Max-Y-Ma/ECE-385/README.md

# ECE-385
Repository for ECE 385 Labs

Google Drive Folder for Lab Reports: https://drive.google.com/drive/folders/1IDm4uJgUrv-CRCThsT9souQDmplNP_dR?usp=sharing
