Max-Y-Ma/ECE-385/Lab5/Report/Lab Report #5 Extra Credit.pdf

# ECE 385

### Spring 2023 Experiment #5 EC

# MIPS Calculations

### Max Ma & Dhruv Kulgod NL / Friday 9:15 AM - 9:30 AM Nick Lu

Overview
SignalTap, a Logic Analyzer IP Core that is integrated into the FPGA fabric of a given design, was used to probe signals during each test program: XOR, Multiplier, and Sort. The signals that were probed were the Program Counter (PC), and HEX0, HEX1, HEX2, and HEX3. The PC register was chosen as the trigger signal. SignalTap was configured to trigger on specific PC values for each of the three required tests. Once the waveforms were captured, they were analyzed to determine the SLC-3 MIPS (millions of instructions per second). The number of instructions were counted for each test. Moreover, the number of cycles was determined by the number of samples taken during each test. This metric was utilized because each sample is taken on the positive edge of the system clock, which corresponds to one clock cycle.

XOR Test Results
The trigger for this test was PC = 0x1A, which corresponds to the moment after the second input value is entered. The captured logic analyzer waveform is shown below in Figure 1. The number of cycles was able to be measured from the sample bar above Figure 1. The number of instructions was counted from the full SignalTap waveform.

Calculations: 9 Instructions, 67 Cycles

9 Instructions

67 Cycles × 50, 000, 000 Cycles

Second ≈ 6, 716, 418 Instructions
Second ≈ 6. 716 MIPS

Figure 1: XOR Test SignalTap Waveform

Multiplier Test Results
The trigger for this test was PC = 0x3A, which starts capturing right after the second input value is entered. The captured logic analyzer waveform is shown below in Figure 2 and Figure 3. The number of cycles was able to be measured from the sample bar above Figure 3. The number of instructions was counted from the full SignalTap waveform.

Calculations: 79 Instructions, 580 Cycles

79 Instructions

580 Cycles × 50, 000, 000 Cycles

Second ≈ 6, 810, 344 Instructions
Second ≈ 6. 810 MIPS

Figure 3: Multiplier Test SignalTap Waveform - Head

Figure 3: Multiplier Test SignalTap Waveform - Tail Sort Test Results
The trigger for this test was PC = 0x77, which is the first instruction when executing the bubble sort algorithm. The captured logic analyzer waveform is shown below in Figure 4 and Figure 5. The number of cycles was able to be measured from the sample bar above Figure 5. The number of instructions was computed using a Python program illustrated in Figure 6 and Figure 7.

Calculations: 1, 638 Instructions, 12, 150 Cycles

1,638 Instructions

12,150 Cycles × 50, 000, 000 Cycles

Second ≈ 6, 740, 741 Instructions
Second ≈ 6. 741 MIPS

Figure 4: Sort Test SignalTap Waveform - Head

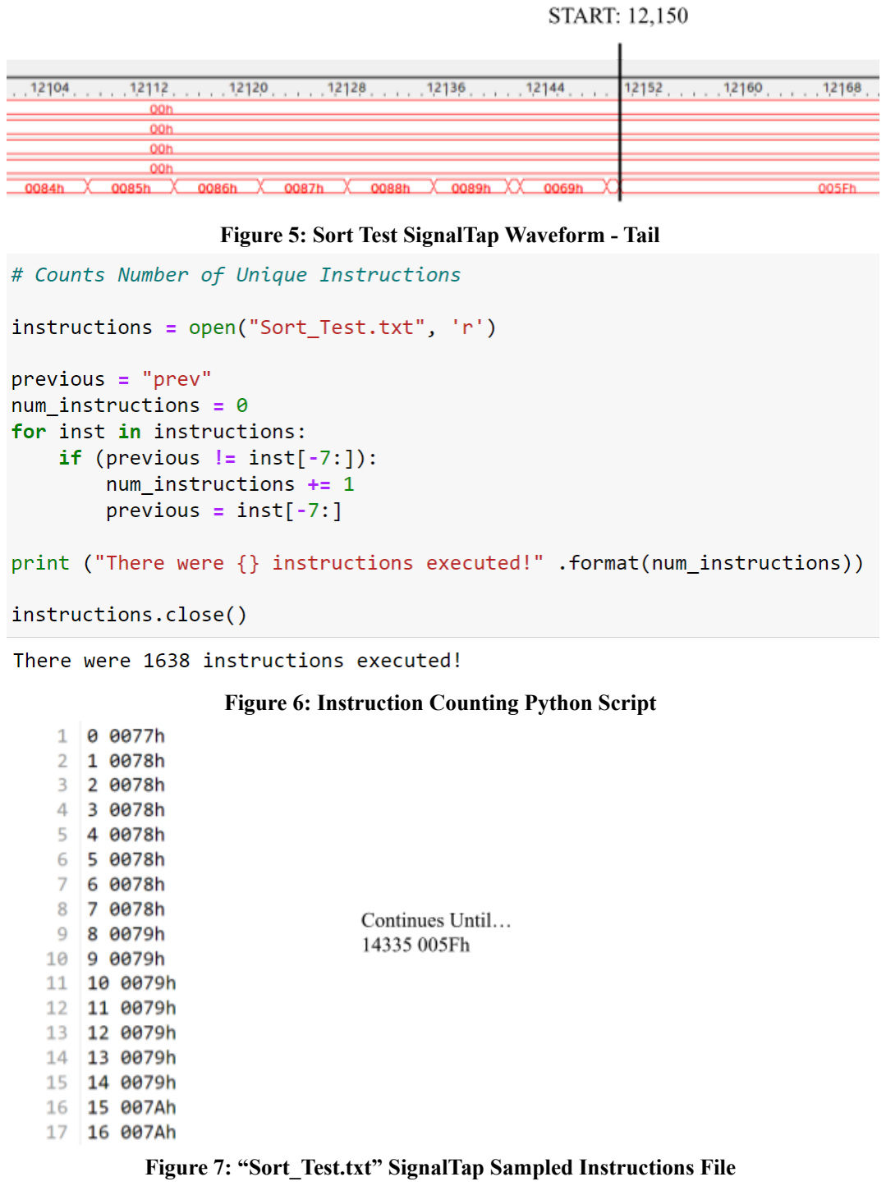
[picture p1: page 4]

Figure 5: Sort Test SignalTap Waveform - Tail

Figure 6: Instruction Counting Python Script

Figure 7: “Sort_Test.txt” SignalTap Sampled Instructions File

Conclusion
After computing the results from each test, the average SLC-3 MIPS is:

Calculations: 6.716 MIPS + 6.810 MIPS + 6.741 MIPS
3 | =

20.267 MIPS
3 ≈ 6. 756 MIPS

This is comparable to the Intel 8048 from 1980!
