Max-Y-Ma/ECE-385/Lab2/Week2/Report/State Diagram Moore FPGA.png

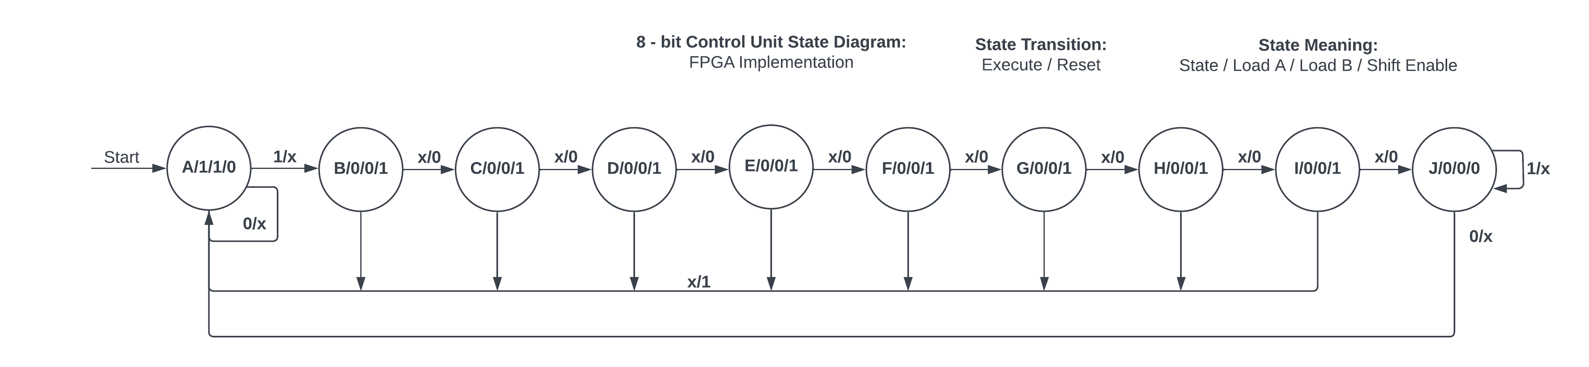
Lab2/Week2/Report/State Diagram Moore FPGA.png
