Max-Y-Ma/ECE-385/(list of files, cad)

Other CAD files:
Lab2/Week2/Logic_Processor_8bit/db/demo_signal_tap_auto_stripped.stp
Lab2/Week2/Logic_Processor_8bit/demo_signal_tap.stp
Lab5/slc_microprocessor/stp3.stp
Lab5/slc_microprocessor/Multiply_Test.stp
