Max-Y-Ma/ECE-385/Lab5/Experiment 5 Test Cases.pdf

# ECE 385 SLC-3 Test Programs

For each test program, the point value and starting address (in hex) is given, followed by a list of instructions used in the test program, and a description of what the program does. To begin each test, input the starting address on the switches and press “Run”.

Note that the top button is typically mapped to "Run" and the bottom button mapped to "Continue", and both buttons pressed simultaneously is the "Reset" functionality.

In the descriptions of the test programs, the term “Checkpoint” is used to refer to a pause instruction with a specified value. “Checkpoint 1” would be a pause instruction that displays
x01 on the LEDs (excluding any I/O flags).

Basic I/O Test 1
Program Start: | x0003
Instructions Tested: | ANDi, LDR, STR, BR

This program uses ANDi to clear R0 (i.e., ANDi R0, R0, 0), which is used as a base register for memory operations (using negative values for the offset). All test programs do this to set up for I/O operations. The program then reads in the data on the switches, writes this value to the hex display, and loops back (using BRnzp as an unconditional jump) to repeat the process indefinitely. When working correctly, the hex displays should appear to always display the value of the switches.

Basic I/O Test 2
Program Start:
Instructions Tested:

x0006
ANDi, LDR, STR, BR, PSE

The code for this program is identical to the previous test, except that it uses pause instructions to ask for input and report output. The first pause instruction (checkpoint 1) will ask for input on the switches. The second and subsequent pauses will display x02 and both ask for input and report that an output is present on the hex display. When operating correctly, each press of the Continue button will transfer the value from the switches to the hex display, but the hex display will not change until Continue is pressed.

Self-Modifying Code Test
Program Start: | x000B
Instructions Tested: | ANDi, ADDi, LDR, STR, BR, JSR, PSE

This program is based upon the same loop as the previous test, but inserts some additional operations. Before the loop begins, JSR 0 is executed. This serves to put the PC address in R7 without actually changing the value of PC. (This usage is common in the remaining tests as well). This PC value is used to load the data for the second pause instruction into a register. The loop then operates normally, except that in each iteration, the data for the pause instruction is incremented and stored back to the proper memory location. The result is that with each iteration of the loop, the pause instruction will display a value on the LEDs one greater than the value in the last iteration.

Auto Counting Test
Program Start: | x009C
Instructions Tested: | ANDi, ADDi, JSR, LDR, STR, BR

This program will display an automatically incrementing counter to the hex displays without the need of inputs after jumping to the program. It loads preset constants into R1 and R2 using LDR which serve as counting variables in a double for loop to create delay between the counter increments. After each loop iteration, the respective counter variable is decremented using the ADDi instruction (ADD R <- R - 1). To traverse between the for loops, the BR instruction is used.

XOR Test
Program Start: | x0014
Instructions Tested: | AND, ANDi, NOT, LDR, BR, PSE

This program performs XOR operation. In sLC-3, there is no dedicated XOR instruction, so the XOR is performed by multiple simple instructions (AND and NOT). The program will ask for input values (checkpoints 1 and 2), XOR them, and display the result on the hex display (checkpoint 3). It will then loop back to the top and repeat the process from checkpoint 1.

Multiplication Test (or, “Lab 4 in Software”)
Program Start: | x0031
Instructions Tested: | AND, ANDi, ADD, ADDi. NOT, LDR, STR, BR, JSR, PSE

This program performs multiplication, using a variation on the shift-and-add algorithm (using ADD Rx, Rx, Rx as a left-shift operation). The program will ask for input values (checkpoints 1 and 2), multiply them, and display the result on the hex display (checkpoint 3). It will then loop back to the top and repeat the process from checkpoint 1. Note multiplication is performed on unsigned values, so negative multiplications are not supported.

Sort Test
Program Start:
Instructions Tested:

x005A
<all>

This program is organized into four parts. The first part is a menu, containing function calls to the other three parts that are executed based on input. The menu contains a single pause instruction, checkpoint –1 (displays xFF on the LEDs). Entering x0001 will call the “data entry” function, entering x0002 will call the “sort” function, and entering x0003 will call the “display” function. Any other value will simply cause the menu to loop back to the start without doing anything.

The data entry function allows the user to enter new data into the list to be sorted. The list is fixed at length 16, no more, no less. The function will display the current index (starting at 0) to be written to the list, and ask for data from the switches (checkpoint 1). It will do this 16 times, displaying the current index each time, before returning control to the menu loop.

The sort function will sort the values in the list using the Bubble Sort algorithm. No feedback is given to the user about the completion of the algorithm; it will return (seemingly) immediately to the menu.

The display function will display, in turn, each member of the list (checkpoint 2). Note that since the hex display will be used to display the data, the index of the value is displayed on the LEDs (LED<7:4>), using the self-modifying code technique used earlier to change the pause instruction in each iteration. A properly sorted list will be displayed in ascending order.
To test this program, the data entry function needs not be used, since sample values are pre-loaded into the list along with the program itself. These values, both in their original order and sorted order, are in Table 1. It is recommended that to demo, the display function should be run first to verify that the sample values are present and unsorted, the sort function should be run second, and the display function should be run again to verify that the sort was successful.

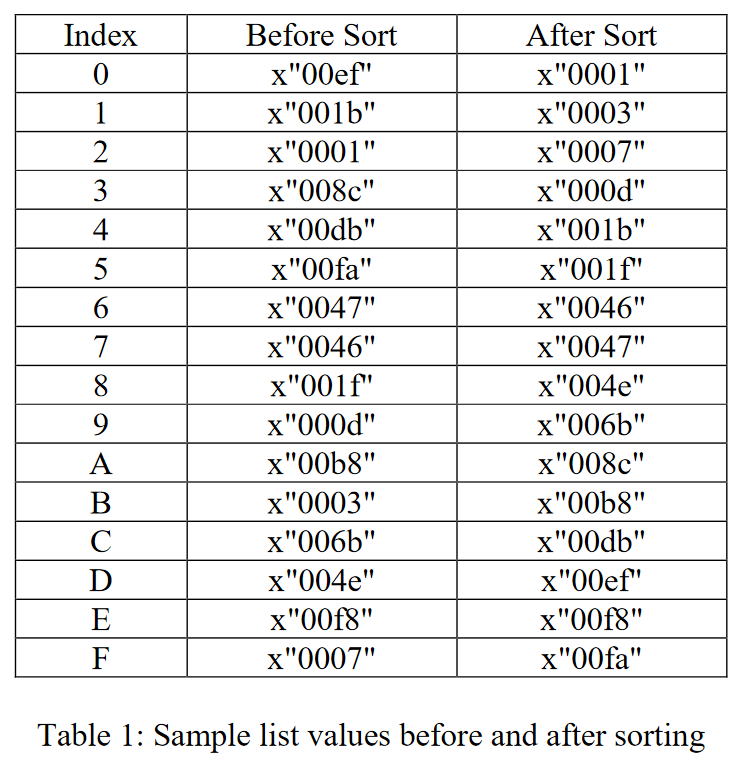
[picture p88: figure]

“Act Once” Test
Program Start: | x002A
Instructions Tested: | ANDi, ADDi, STR, JSR, JMP, PSE

This program is a simple loop that counts up from zero, once per iteration, and displays the count on the hex display (checkpoint 1). When operating correctly, the counter will increase by one (no more, no less) with each press of Continue (i.e., the CPU will act once per press.) This test need only be run if the “act once” functionality of the run or continue buttons is called into question in the course of running other tests. At the TA’s discretion, if this functionality appears to be present during observation of other tests, especially after the display function of the sort test, the points for this test may be awarded without running the test itself.
