Max-Y-Ma/ECE-385/Lab5/Instruction_Counter/Sort_Test.txt

0 0077h 
1 0078h 
2 0078h 
3 0078h 
4 0078h 
5 0078h 
6 0078h 
7 0078h 
8 0079h 
9 0079h 
10 0079h 
11 0079h 
12 0079h 
13 0079h 
14 0079h 
15 007Ah 
16 007Ah 
17 007Ah 
18 007Ah 
19 007Ah 
20 007Ah 
21 007Ah 
22 007Bh 
23 007Bh 
24 007Bh 
25 007Bh 
26 007Bh 
27 007Bh 
28 007Bh 
29 007Bh 
30 007Bh 
31 007Bh 
32 007Bh 
33 007Ch 
34 007Ch 
35 007Ch 
36 007Ch 
37 007Ch 
38 007Ch 
39 007Ch 
40 007Ch 
41 007Ch 
42 007Ch 
43 007Ch 
44 007Dh 
45 007Dh 
46 007Dh 
47 007Dh 
48 007Dh 
49 007Dh 
50 007Dh 
51 007Eh 
52 007Eh 
53 007Eh 
54 007Eh 
55 007Eh 
56 007Eh 
57 007Eh 
58 007Fh 
59 007Fh 
60 007Fh 
61 007Fh 
62 007Fh 
63 007Fh 
64 007Fh 
65 0080h 
66 0080h 
67 0080h 
68 0080h 
69 0080h 
70 0080h 
71 0080h 
72 0081h 
73 0081h 
74 0081h 
75 0081h 
76 0081h 
77 0081h 
78 0081h 
79 0081h 
80 0081h 
81 0081h 
82 0081h 
83 0082h 
84 0082h 
85 0082h 
86 0082h 
87 0082h 
88 0082h 
89 0082h 
90 0082h 
91 0082h 
92 0082h 
93 0082h 
94 0083h 
95 0083h 
96 0083h 
97 0083h 
98 0083h 
99 0083h 
100  0083h 
101  0083h 
102  0083h 
103  0083h 
104  0083h 
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
127  007Ah 
128  007Ah 
129  007Ah 
130  007Ah 
131  007Ah 
132  007Ah 
133  007Ah 
134  007Bh 
135  007Bh 
136  007Bh 
137  007Bh 
138  007Bh 
139  007Bh 
140  007Bh 
141  007Bh 
142  007Bh 
143  007Bh 
144  007Bh 
145  007Ch 
146  007Ch 
147  007Ch 
148  007Ch 
149  007Ch 
150  007Ch 
151  007Ch 
152  007Ch 
153  007Ch 
154  007Ch 
155  007Ch 
156  007Dh 
157  007Dh 
158  007Dh 
159  007Dh 
160  007Dh 
161  007Dh 
162  007Dh 
163  007Eh 
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
14313 005Fh 
14314 005Fh 
14315 005Fh 
14316 005Fh 
14317 005Fh 
14318 005Fh 
14319 005Fh 
14320 005Fh 
14321 005Fh 
14322 005Fh 
14323 005Fh 
14324 005Fh 
14325 005Fh 
14326 005Fh 
14327 005Fh 
14328 005Fh 
14329 005Fh 
14330 005Fh 
14331 005Fh 
14332 005Fh 
14333 005Fh 
14334 005Fh 
14335 005Fh
