Max-Y-Ma/ECE-385/Lab5/Report/Simulations/I_O_Test_1.pdf

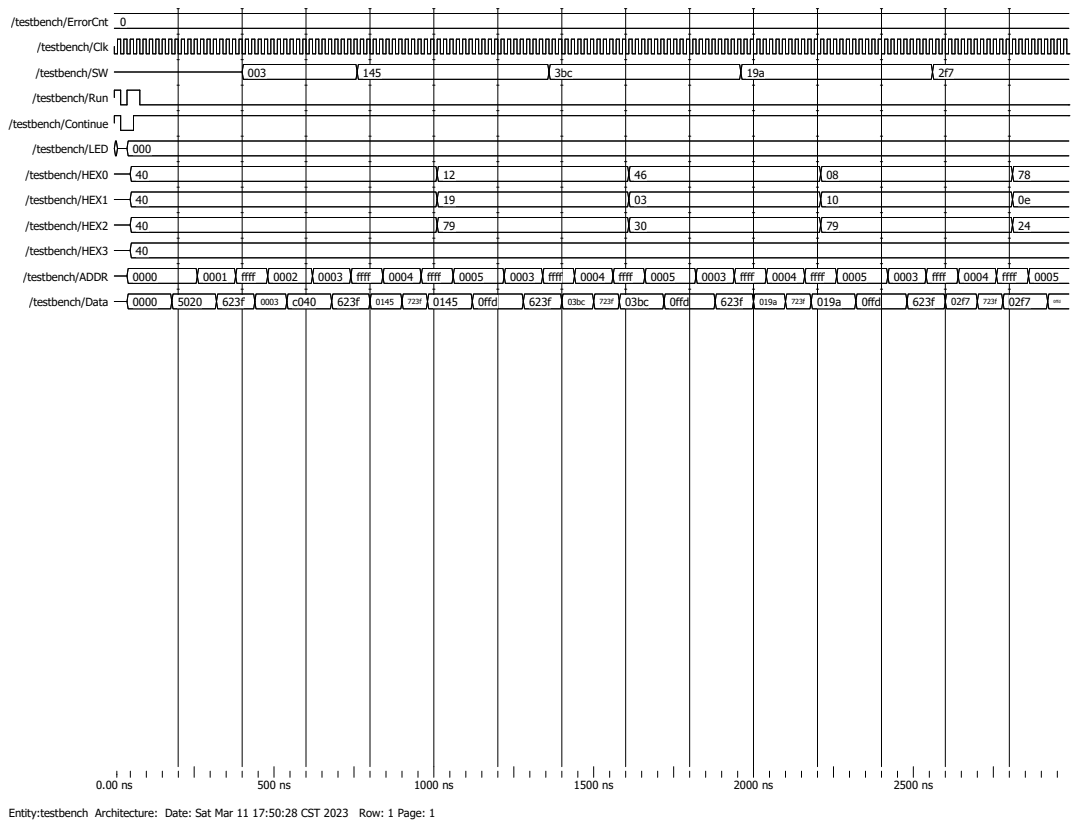
[picture p101: page 1]
ffff; 0003 ffff; 0004 ffff; 0ffd; /testbench/ErrorCnt 0; /testbench/Clk; /testbench/SW; /testbench/Run; /testbench/Continue; /testbench/LED; /testbench/HEX0; /testbench/HEX1; /testbench/HEX2; /testbench/HEX3; /testbench/ADDR; /testbench/Data

Entity:testbench Architecture: Date: Sat Mar 11 17:50:28 CST 2023 Row: 1 Page: 1
