Max-Y-Ma/ECE-385/Lab5/Report/Simulations/I_O_Test_2.pdf

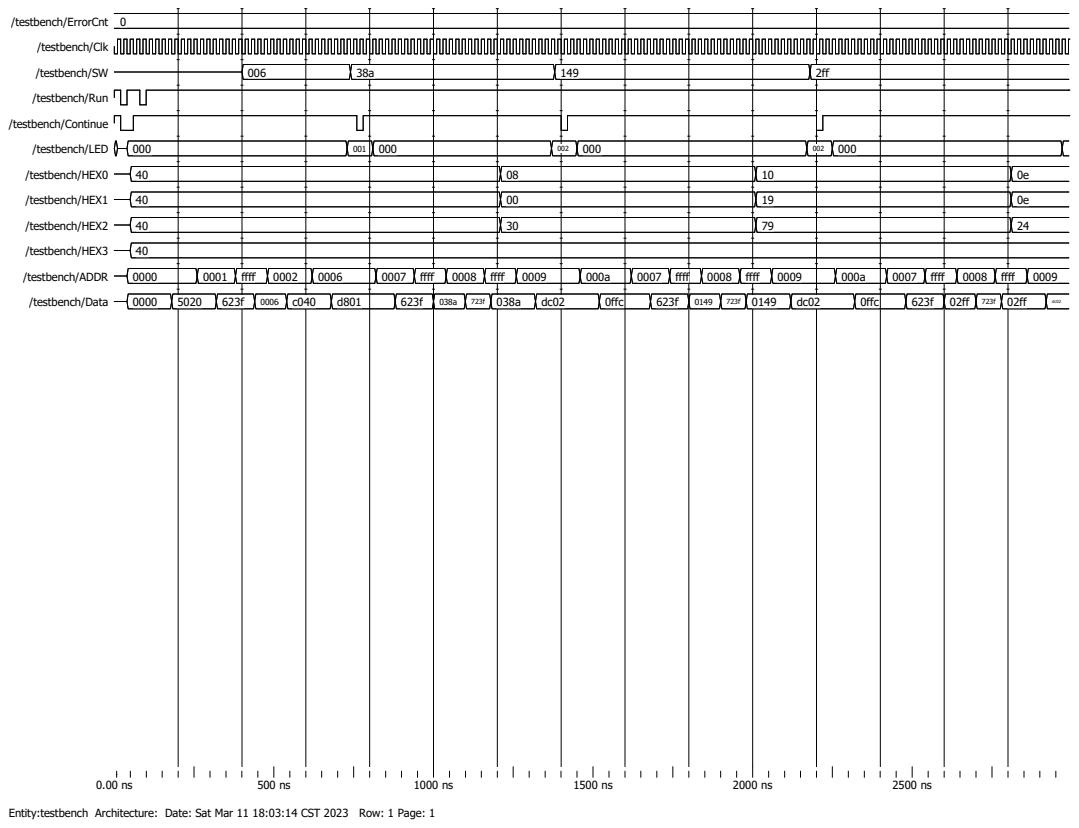
[picture p102: page 1]
ffff; 0007 ffff; 0008 ffff; 0ffc; /testbench/ErrorCnt 0; /testbench/Clk; /testbench/SW; /testbench/Run; /testbench/Continue; /testbench/LED; /testbench/HEX0; /testbench/HEX1; /testbench/HEX2; /testbench/HEX3; /testbench/ADDR; /testbench/Data

Entity:testbench Architecture: Date: Sat Mar 11 18:03:14 CST 2023 Row: 1 Page: 1
