Max-Y-Ma/ECE-385/Lab5/Report/Simulations/Multiply_Test.pdf

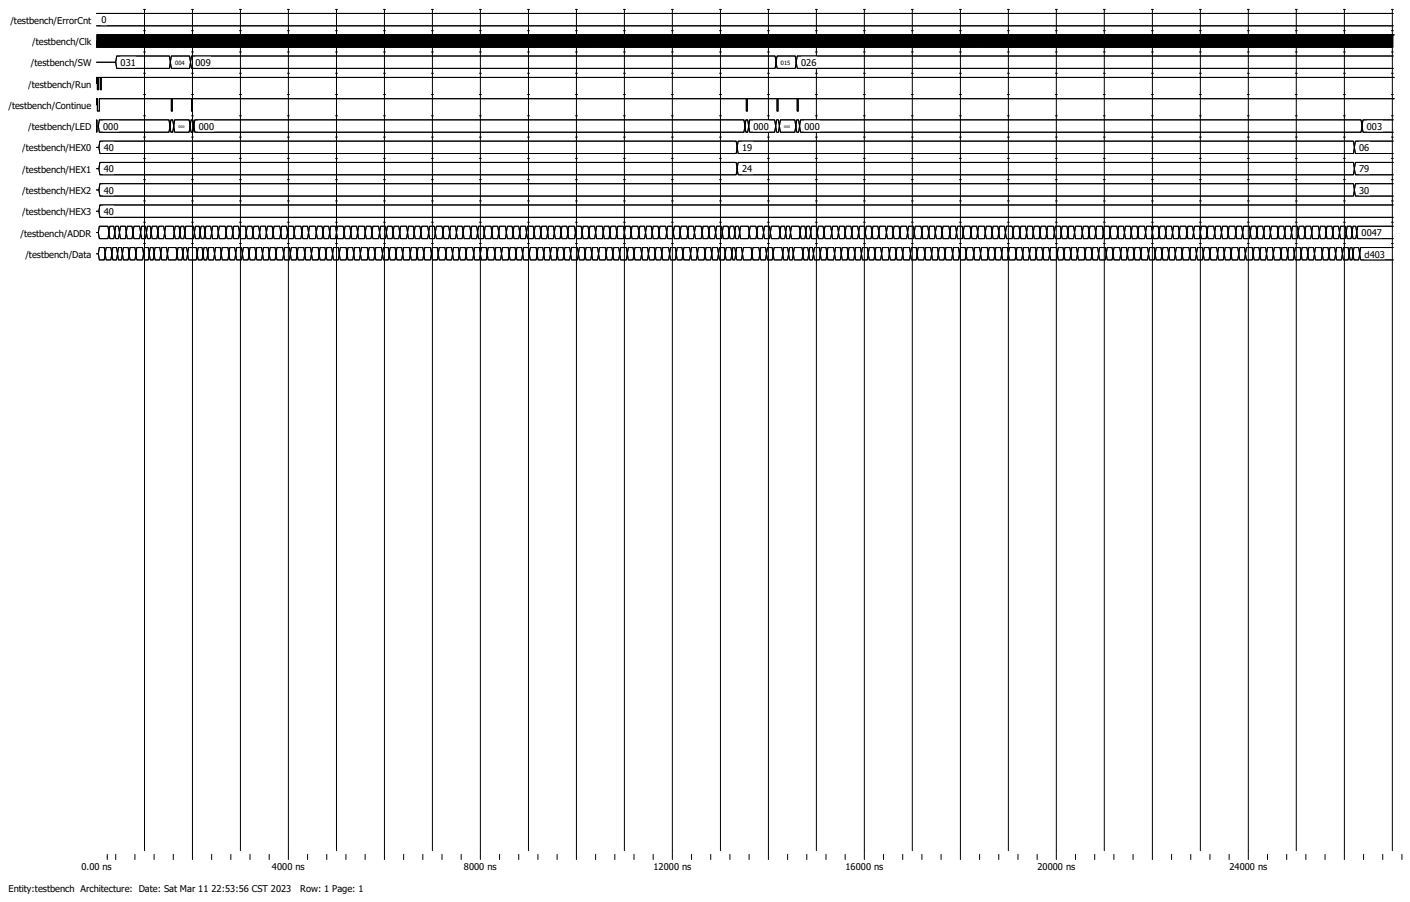
[picture p103: page 1]
/testbench/ErrorCnt 0; /testbench/Clk; /testbench/SW; /testbench/Run; /testbench/Continue; /testbench/LED 000; /testbench/HEX0 40; /testbench/HEX1 40; /testbench/HEX2 40; /testbench/HEX3 40; /testbench/ADDR; /testbench/Data

Entity:testbench Architecture: Date: Sat Mar 11 22:53:56 CST 2023 Row: 1 Page: 1
