Max-Y-Ma/ECE-385/Lab5/Report/Simulations/Self_Modifying_Test.pdf

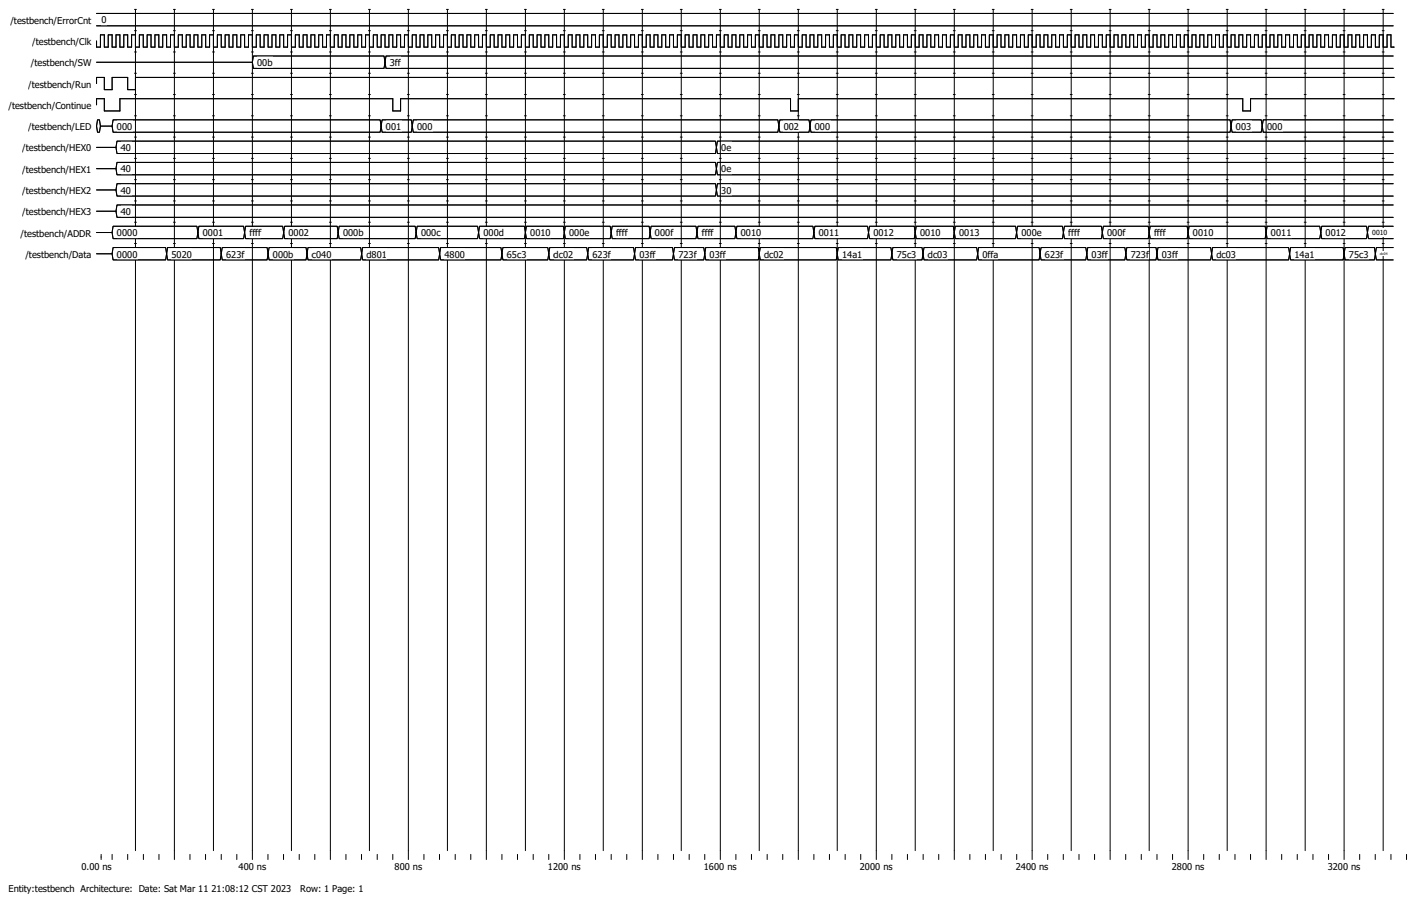
[picture p104: page 1]
ffff; 0ffa; /testbench/ErrorCnt 0; /testbench/Clk; /testbench/SW; /testbench/Run; /testbench/Continue; /testbench/LED; /testbench/HEX0; /testbench/HEX1; /testbench/HEX2; /testbench/HEX3; /testbench/ADDR; /testbench/Data

Entity:testbench Architecture: Date: Sat Mar 11 21:08:12 CST 2023 Row: 1 Page: 1
