Max-Y-Ma/ECE-385/Lab5/Report/Simulations/Sort_Test_2.pdf

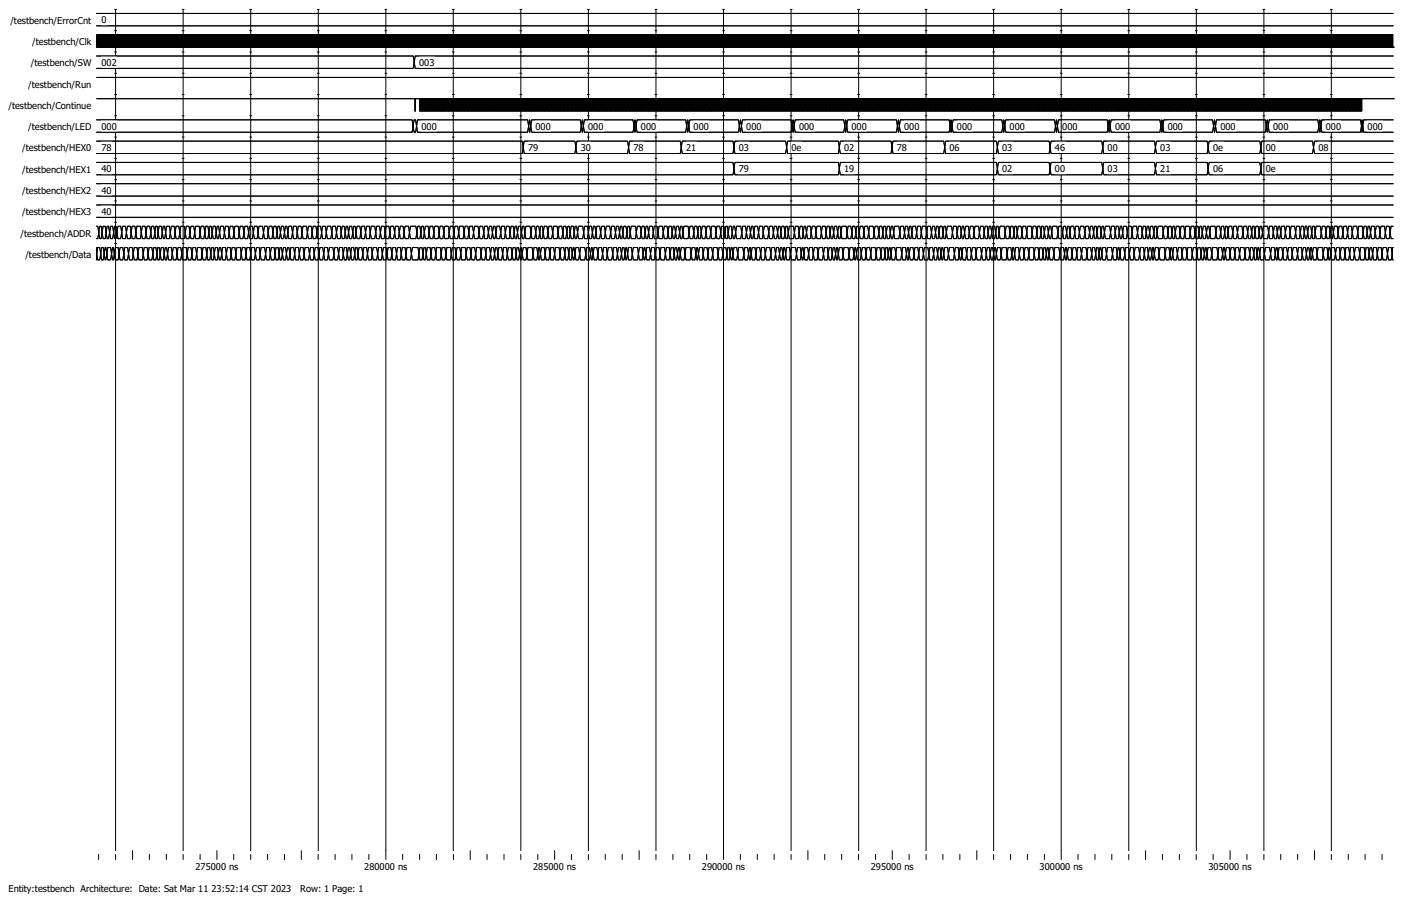
[picture p105: page 1]
/testbench/ErrorCnt; /testbench/Clk; /testbench/SW 002; /testbench/Run; /testbench/Continue; /testbench/LED 000; /testbench/HEX0 78; /testbench/HEX1 40; /testbench/HEX2 40; /testbench/HEX3 40; /testbench/ADDR; /testbench/Data

Entity:testbench Architecture: Date: Sat Mar 11 23:52:14 CST 2023 Row: 1 Page: 1
