Max-Y-Ma/ECE-385/Lab5/Report/Simulations/XOR_Test.pdf

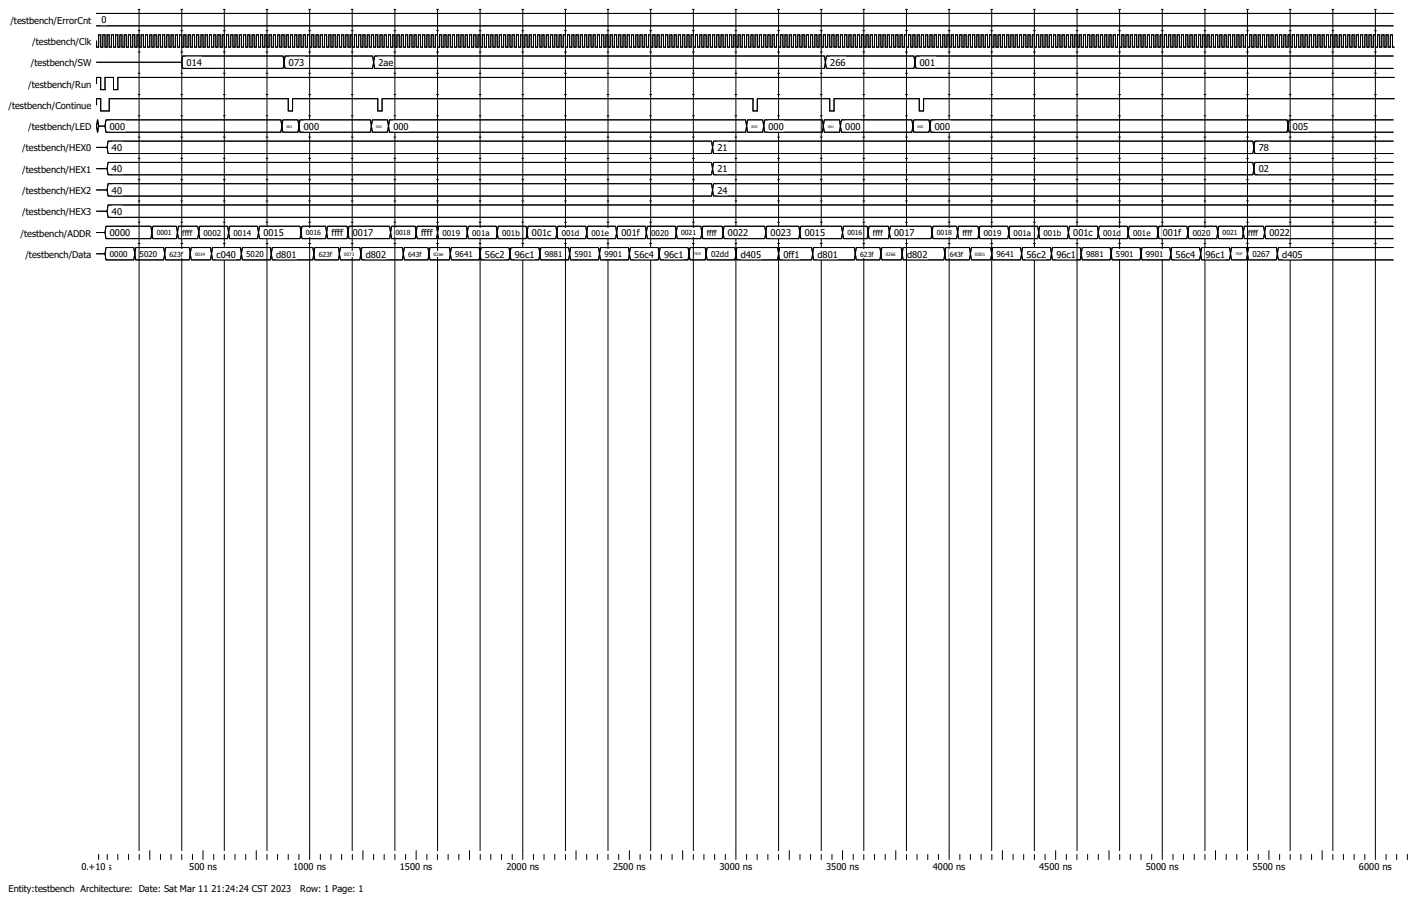
[picture p106: page 1]
ffff 0002; ffff; ffff 0022; ffff 0017; ffff 0019; /testbench/ErrorCnt 0; /testbench/Clk; /testbench/SW; /testbench/Run; /testbench/Continue; /testbench/LED; /testbench/HEX0; /testbench/HEX1; /testbench/HEX2; /testbench/HEX3; /testbench/ADDR; /testbench/Data

Entity:testbench Architecture: Date: Sat Mar 11 21:24:24 CST 2023 Row: 1 Page: 1
