Max-Y-Ma/ECE-385/Lab4/Report/Annotated Multiplier Simulation Waveform.pdf

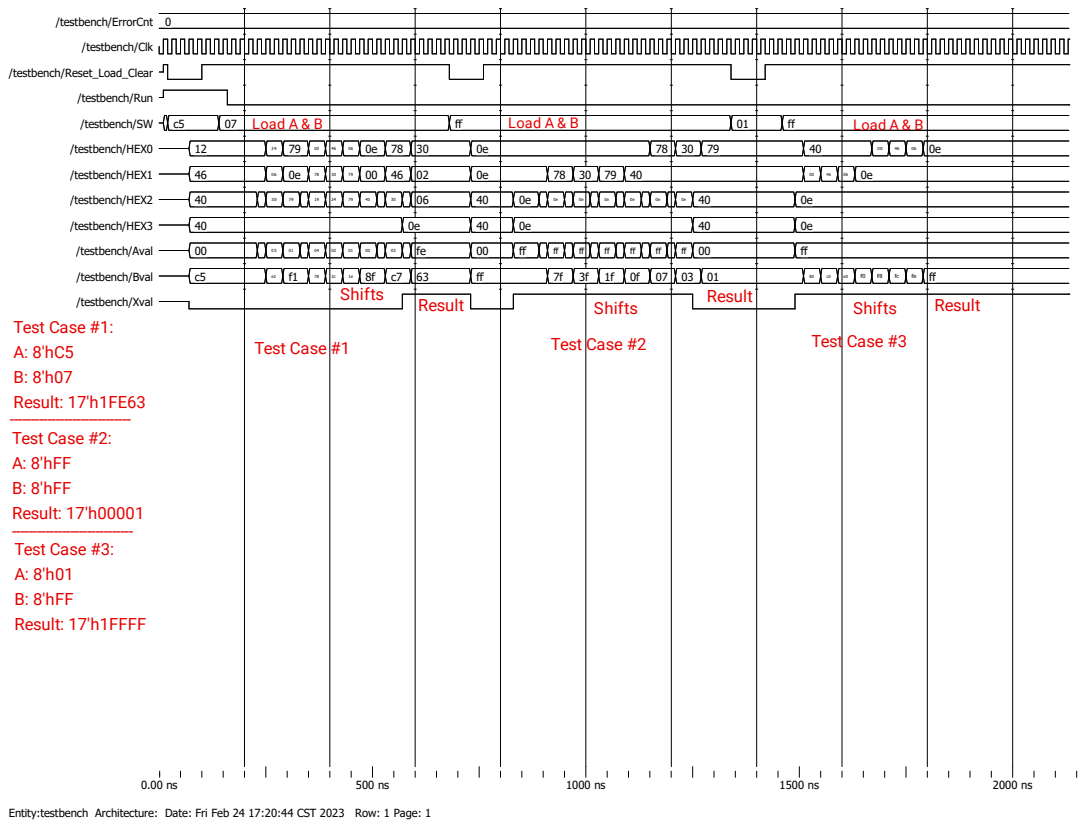
[picture p107: page 1]
/testbench/ErrorCnt 0; /testbench/Clk; /testbench/Reset_Load_Clear; /testbench/Run; /testbench/SW; /testbench/HEX0; /testbench/HEX1; /testbench/HEX2; /testbench/HEX3; /testbench/Aval; /testbench/Bval; /testbench/Xval

Entity:testbench Architecture: Date: Fri Feb 24 17:20:44 CST 2023 Row: 1 Page: 1
