Max-Y-Ma/ECE-385/Lab3/Report/Annotated Simulation.pdf

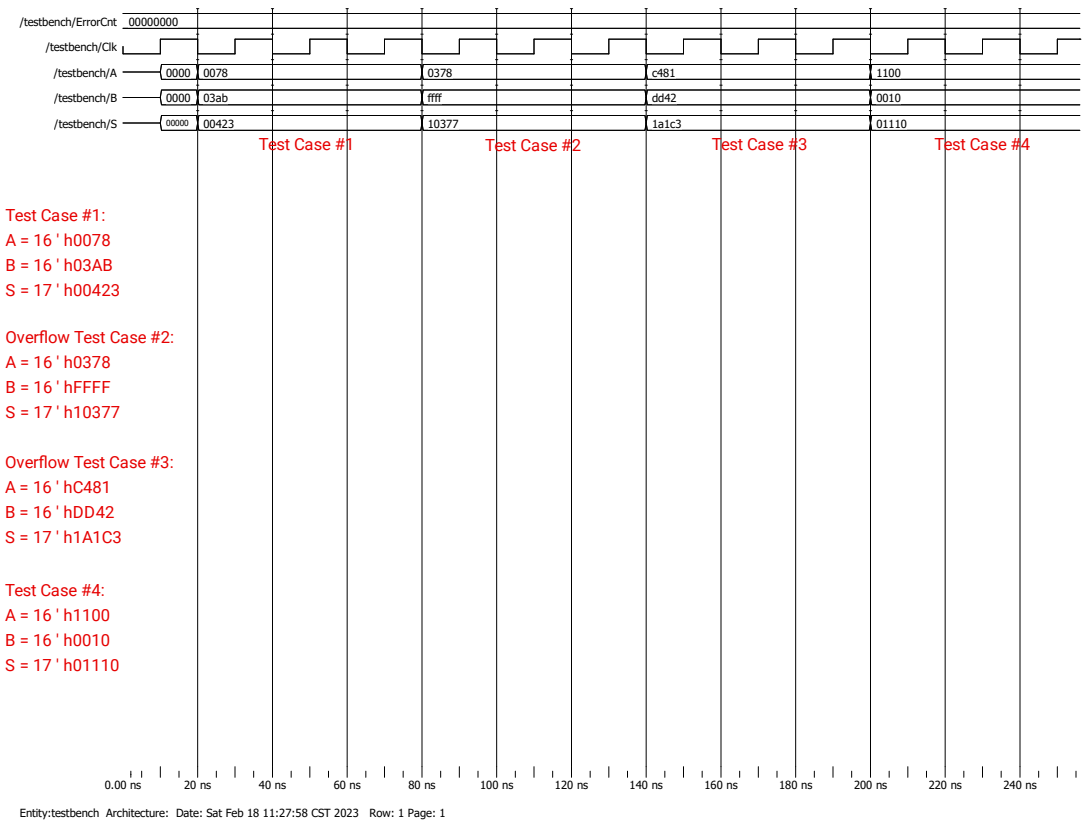
[picture p108: page 1]
ffff; /testbench/ErrorCnt 00000000; /testbench/Clk; /testbench/A; /testbench/B; /testbench/S

Entity:testbench Architecture: Date: Sat Feb 18 11:27:58 CST 2023 Row: 1 Page: 1
