Max-Y-Ma/ECE-385/Lab2/Week2/Report/Logic_Process_8bit_Waveform.pdf

33 | 55 | 00

010 110

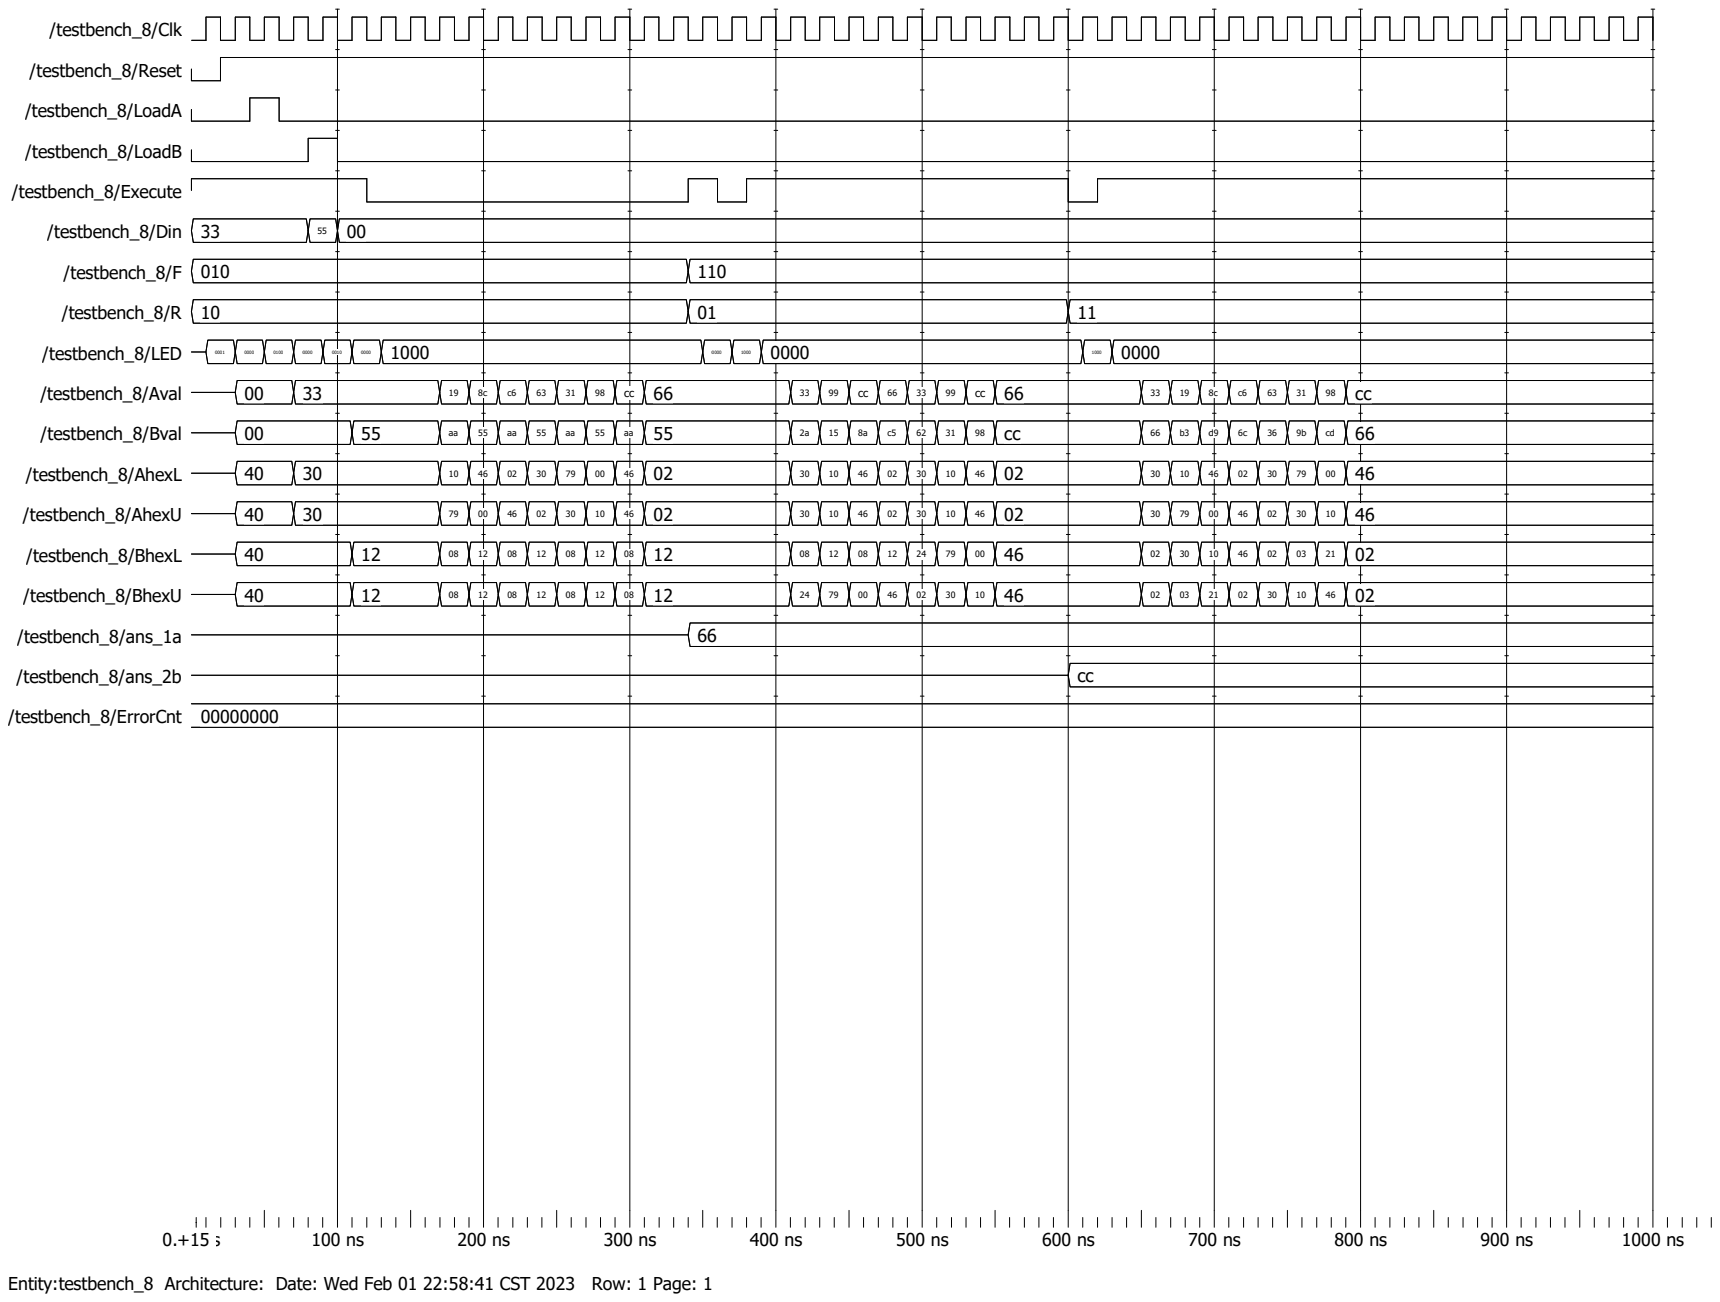
[picture p109: page 1]
/testbench_8/Clk; /testbench_8/Reset; /testbench_8/LoadA; /testbench_8/LoadB; /testbench_8/Execute; /testbench_8/Din 33; /testbench_8/F 010; /testbench_8/R 10; /testbench_8/LED; /testbench_8/Aval; /testbench_8/Bval; /testbench_8/AhexL; /testbench_8/AhexU; /testbench_8/BhexL; /testbench_8/BhexU; /testbench_8/ans_1a; /testbench_8/ans_2b; /testbench_8/ErrorCnt 00000000

Entity:testbench_8 Architecture: Date: Wed Feb 01 22:58:41 CST 2023 Row: 1 Page: 1
