Max-Y-Ma/ECE-385/Lab2/Week1/CLR_S_Kmap.pdf

## PRODUCT of SUMS

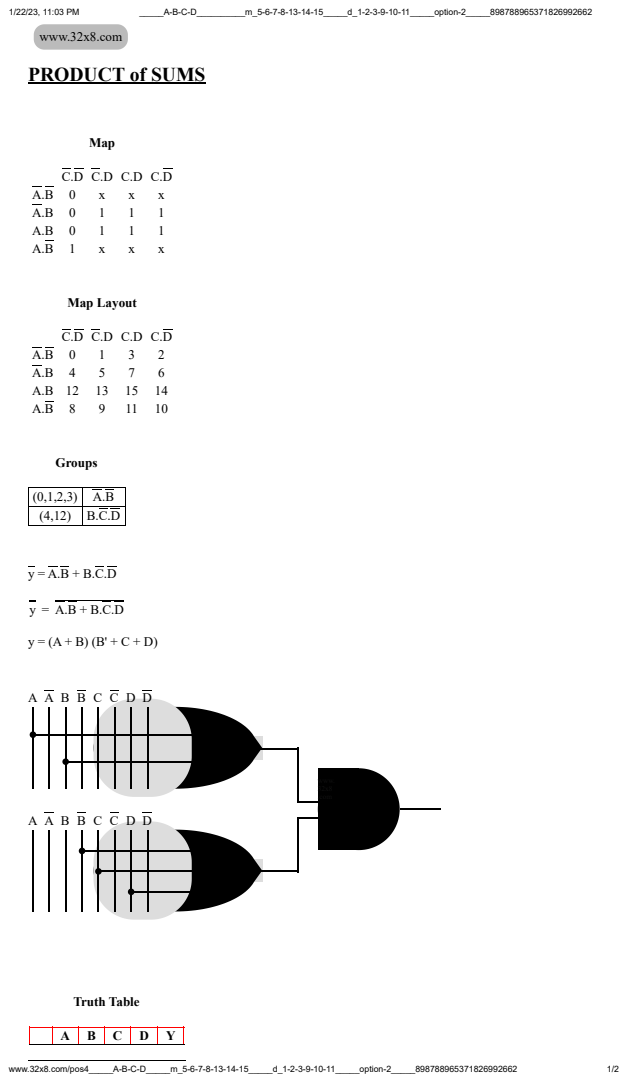
[picture p110: page 1]
_____A-B-C-D__________m_5-6-7-8-13-14-15_____d_1-2-3-9-10-11_____option-2_____898788965371826992662; www.32x8.com/pos4_____A-B-C-D_____m_5-6-7-8-13-14-15_____d_1-2-3-9-10-11_____option-2_____898788965371826992662; www.32x8.com; Map; Map Layout; Groups; Truth Table; www. 32x8 .com

(0,1,2,3) | A.B
(4,12) | B.C.D

1/22/23, 11:03 PM | _____A-B-C-D__________m_5-6-7-8-13-14-15_____d_1-2-3-9-10-11_____option-2_____898788965371826992662
www.32x8.com/pos4_____A-B-C-D_____m_5-6-7-8-13-14-15_____d_1-2-3-9-10-11_____option-2_____898788965371826992662 | 2/2
0 | 0 | 0 | 0 | 0 | 0
1 | 0 | 0 | 0 | 1 | x
2 | 0 | 0 | 1 | 0 | x
3 | 0 | 0 | 1 | 1 | x
4 | 0 | 1 | 0 | 0 | 0
5 | 0 | 1 | 0 | 1 | 1
6 | 0 | 1 | 1 | 0 | 1
7 | 0 | 1 | 1 | 1 | 1
8 | 1 | 0 | 0 | 0 | 1
9 | 1 | 0 | 0 | 1 | x
10 | 1 | 0 | 1 | 0 | x
11 | 1 | 0 | 1 | 1 | x
12 | 1 | 1 | 0 | 0 | 0
13 | 1 | 1 | 0 | 1 | 1
14 | 1 | 1 | 1 | 0 | 1
15 | 1 | 1 | 1 | 1 | 1

© 2014-2023
