Max-Y-Ma/ECE-385/Lab2/Week1/Q+_Kmap.pdf

## www.32x8.com

# PRODUCT of SUMS

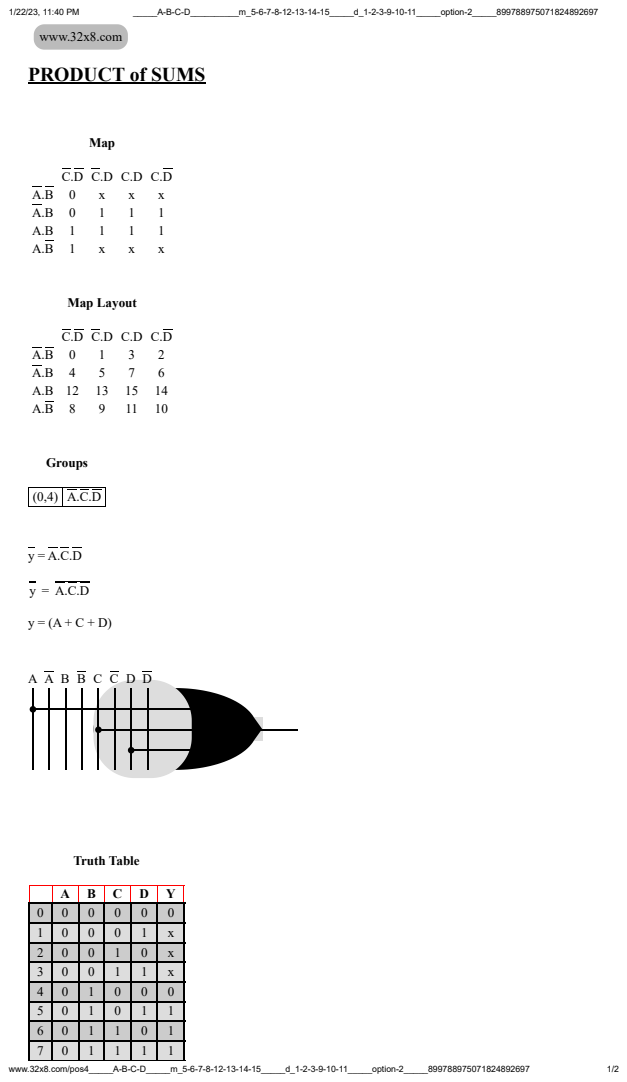
[picture p111: page 1]
_____A-B-C-D__________m_5-6-7-8-12-13-14-15_____d_1-2-3-9-10-11_____option-2_____899788975071824892697; www.32x8.com/pos4_____A-B-C-D_____m_5-6-7-8-12-13-14-15_____d_1-2-3-9-10-11_____option-2_____899788975071824892697; Map; Map Layout; Groups; Truth Table

1/22/23, 11:40 PM | _____A-B-C-D__________m_5-6-7-8-12-13-14-15_____d_1-2-3-9-10-11_____option-2_____899788975071824892697
www.32x8.com/pos4_____A-B-C-D_____m_5-6-7-8-12-13-14-15_____d_1-2-3-9-10-11_____option-2_____899788975071824892697 | 2/2
8 | 1 | 0 | 0 | 0 | 1
9 | 1 | 0 | 0 | 1 | x
10 | 1 | 0 | 1 | 0 | x
11 | 1 | 0 | 1 | 1 | x
12 | 1 | 1 | 0 | 0 | 1
13 | 1 | 1 | 0 | 1 | 1
14 | 1 | 1 | 1 | 0 | 1
15 | 1 | 1 | 1 | 1 | 1

© 2014-2023
