Max-Y-Ma/ECE-385/(list of files, drawings)

Other design files:
Lab2/Week1/4-bit_ALU.fzz
