Max-Y-Ma/ECE-385/Lab5/slc_microprocessor/src/slc3_testtop.sv

//SLC-3 Top level module for both simulation and synthesis using test_memory
//All synchronizers go here (both inputs and outputs)

module slc3_testtop(
	input logic [9:0] SW,
	input logic	Clk, Run, Continue,
	output logic [9:0] LED,
	output logic [6:0] HEX0, HEX1, HEX2, HEX3,
	output logic       CE, UB, LB, OE, WE,
	output logic [15:0] ADDR,
	output logic [15:0] Data
);

// Input button synchronizer to cross clock domain
logic RUN_S, CONTINUE_S;
sync button_sync[1:0] (Clk, {Run, Continue}, {RUN_S, CONTINUE_S});

logic [15:0] Data_from_SRAM, Data_to_SRAM; //needs to be wire since bidirectional
//logic OE, WE;
//logic [15:0] ADDR;

// Declaration of push button active high signals	
logic Reset_ah, Continue_ah, Run_ah;

//assign Reset_ah = ~RESET_S;
assign Reset_ah = ~RUN_S & ~CONTINUE_S;
assign Run_ah = ~RUN_S;
assign Continue_ah = ~CONTINUE_S;
assign Data = Data_to_SRAM;

slc3 slc(.Reset(Reset_ah), .Continue(Continue_ah), .Run(Run_ah), .*);
test_memory mem(.Reset(Reset_ah), .Clk(Clk), .data(Data_to_SRAM), .address(ADDR[9:0]), .rden(OE), .wren(WE), .readout(Data_from_SRAM) );

endmodule
