Max-Y-Ma/ECE-385/Lab2/Week2/logic_processor_4bit/Control.sv

//Two-always example for state machine

module control (input  logic Clk, Reset, LoadA, LoadB, Execute,
                output logic Shift_En, Ld_A, Ld_B );

    // Declare signals curr_state, next_state of type enum
    // with enum values of A, B, ..., F as the state values
	 // Note that the length implies a max of 8 states, so you will need to bump this up for 8-bits
    enum logic [3:0] {A, B, C, D, E, F, G, H, I, J}   curr_state, next_state; 

	//updates flip flop, current state is the only one
    always_ff @ (posedge Clk)  
    begin
        if (Reset)
            curr_state <= A;
        else 
            curr_state <= next_state;
    end

    // Assign outputs based on state
	 always_comb
    begin
        
		  next_state  = curr_state;	//required because I haven't enumerated all possibilities below
        unique case (curr_state) 

            A :    if (Execute)
                       next_state = B;
            B :    next_state = C;
            C :    next_state = D;
            D :    next_state = E;
            E :    next_state = F;
				F :	 next_state = G;
				G :	 next_state = H;
				H : 	 next_state = I;
				I : 	 next_state = J;
            J :    if (~Execute) 
                       next_state = A;
							  
        endcase
   
		  // Assign outputs based on ‘state’
        case (curr_state) 
	   	   A: 
	         begin
                Ld_A = LoadA;
                Ld_B = LoadB;
                Shift_En = 1'b0;
		      end
	   	   J: 
		      begin
                Ld_A = 1'b0;
                Ld_B = 1'b0;
                Shift_En = 1'b0;
		      end
	   	   default:  //default case, can also have default assignments for Ld_A and Ld_B before case
		      begin 
                Ld_A = 1'b0;
                Ld_B = 1'b0;
                Shift_En = 1'b1;
		      end
        endcase
    end

endmodule
