Max-Y-Ma/ECE-385/Lab5/slc_microprocessor/src/testbench.sv

////////////////////////////////////////////////
////// STATE DIAGRAM / DATAPATH TESTBENCH //////
////////////////////////////////////////////////
//
//module testbench();
//
//timeunit 10ns;	// Half clock cycle at 50 MHz
//timeprecision 1ns;
//
//// Error Tracking
//integer ErrorCnt = 0;
//
//// Clock
//logic Clk;
//
//initial begin: CLOCK_INITIALIZATION
//    Clk = 0;
//end 
//
//always begin : CLOCK_GENERATION
//	#1 Clk = ~Clk;
//end
//
//// Input Signals
//logic	Reset, Run, Continue;
//logic [3:0]  	Opcode;
//logic         	IR_5;
//logic         	IR_11;
//logic         	BEN;
//
//// Output Signals
//logic   			LD_MAR, LD_MDR, LD_IR, LD_BEN, LD_CC, LD_REG, LD_PC, LD_LED;
//									
//logic        	GatePC, GateMDR, GateALU, GateMARMUX;
//									
//logic [1:0]  	PCMUX;
//logic        	DRMUX, SR1MUX, SR2MUX, ADDR1MUX;
//logic [1:0]  	ADDR2MUX, ALUK;
//
//logic [15:0] 	MAR, MDR, IR, PC, BUS;
//logic [15:0] 	MDR_In, ADDR;
//				  
//logic       	Mem_OE, Mem_WE;
//
//logic [9:0]    LED;
//
//logic [3:0] curr_state, next_state;
//
//assign curr_state = UUT2.State;
//assign next_state = UUT2.Next_state;
//
//logic MIO_EN;
//assign MIO_EN = Mem_OE;
//
////Reg files
//
//logic [15:0] R0, R1, R2, R3, R4, R5, R6, R7;
//
//assign R0 = UUT.RegFile_.Reg[0];
//assign R1 = UUT.RegFile_.Reg[1];
//assign R2 = UUT.RegFile_.Reg[2];
//assign R3 = UUT.RegFile_.Reg[3];
//assign R4 = UUT.RegFile_.Reg[4];
//assign R5 = UUT.RegFile_.Reg[5];
//assign R6 = UUT.RegFile_.Reg[6];
//assign R7 = UUT.RegFile_.Reg[7];
//
////Include Mem2IO
//
//assign ADDR = MAR; 
//logic [9:0] SW;
//logic [15:0] Data_from_CPU, Data_from_SRAM;
//logic [15:0] Data_to_CPU, Data_to_SRAM;
//
//initial begin: SIGNAL_INITIALIZATION
//#1 Run = 1'b1;
//	Continue = 1'b1;
//	Reset = 1'b1;
//	IR_5 = 1'b0;
//	IR_11 = 1'b0;
//	BEN = 1'b0;
//	SW = 10'h6;
//end
//
//
//
//
//// Unit Under Test
//
//assign Opcode = IR[15:12];
//
//datapath UUT(.*);
//ISDU UUT2(
//	.*, .Opcode(Opcode), .IR_5(IR[5]), .IR_11(IR[11]), .ledVect12(IR[9:0])
//);
//test_memory mem(.Reset(Reset), 
//					 .Clk(Clk), 
//					 .data(Data_to_SRAM), 
//					 .address(MAR[9:0]), 
//					 .rden(Mem_OE), 
//					 .wren(Mem_WE), 
//					 .readout(Data_from_SRAM));
//					 
//					 
//					 
////Hex display
//
//logic [3:0] hex_4 [3:0];
////HexDriver hex_drivers[3:0] (hex_4, {HEX3, HEX2, HEX1, HEX0});
//
//
//Mem2IO memory_subsystem(
//    .*, .Reset(Reset), .ADDR(ADDR), .Switches(SW), .OE(Mem_OE), .WE(Mem_WE),
//    .HEX0(hex_4[0][3:0]), .HEX1(hex_4[1][3:0]), .HEX2(hex_4[2][3:0]), .HEX3(hex_4[3][3:0]),
//    .Data_from_CPU(MDR), .Data_to_CPU(MDR_In),
//    .Data_from_SRAM(Data_from_SRAM), .Data_to_SRAM(Data_to_SRAM)
//);
//
//initial begin: TESTS
//// Test 1: Normal Test
//	
//#4 Reset = 1'b0;
//	Run = 1'b1;
//
//	
//// if ()
////			ErrorCnt++;
////			
////// Console Output in ModelSim
////if (ErrorCnt == 0)
////	$display("Success!");  
////else
////	$display("%d error(s) detected. Try again!", ErrorCnt);
//	
//end
//
//endmodule

/////////////////////////////////
//// REAL MEMORY TESTBENCH //////
/////////////////////////////////

module testbench();

timeunit 10ns;	// Half clock cycle at 50 MHz
timeprecision 1ns;

// Error Tracking
integer ErrorCnt = 0;

// Clock
logic Clk;

initial begin: CLOCK_INITIALIZATION
    Clk = 0;
end 

always begin : CLOCK_GENERATION
	#1 Clk = ~Clk;
end

// Input Signals
logic [9:0] SW;
logic Run, Continue;

// Output Signals
logic [9:0] LED;
logic [6:0] HEX0, HEX1, HEX2, HEX3;
logic [15:0] ADDR;
logic [15:0] Data;
logic       CE, UB, LB, OE, WE;

initial begin: SIGNAL_INITIALIZATION
	// Active Low
	Run = 1'b1;
	Continue = 1'b1;
end

// Unit Under Test
slc3_testtop UUT(.*);

initial begin: TESTS

// Test 1: Basic I/O Test 1
//#2 Run = 1'b0;
//   Continue = 1'b0;
//	
//#2 Run = 1'b1;
//	Continue = 1'b0;
//
//#2 Run = 1'b1;
//   Continue = 1'b1;	
//
//#2 Run = 1'b0;
//
//while (1) begin
//	#2 $display("ADDR = %0d", ADDR);  
//	if (ADDR == 16'hFFFF) begin
//		SW = 16'h0003;
//		#10;
//		break;
//	end
//end
//
//while (1) begin
//	#2 $display("ADDR = %0d", ADDR);  
//	if (ADDR == 16'hFFFF) begin
//		SW = 16'h0145;
//		#30;
//		break;
//	end
//end
//
//while (1) begin
//	#2 $display("ADDR = %0d", ADDR);  
//	if (ADDR == 16'hFFFF) begin
//		SW = 16'h03BC;
//		#30;
//		break;
//	end
//end
//
//while (1) begin
//	#2 $display("ADDR = %0d", ADDR);  
//	if (ADDR == 16'hFFFF) begin
//		SW = 16'h019A;
//		#30;
//		break;
//	end
//end
//
//while (1) begin
//	#2 $display("ADDR = %0d", ADDR);  
//	if (ADDR == 16'hFFFF) begin
//		SW = 16'h02F7;
//		#30;
//		break;
//	end
//end

// Test 2: Basic I/O Test 2
//#2 Run = 1'b0;
//   Continue = 1'b0;
//	
//#2 Run = 1'b1;
//	Continue = 1'b0;
//
//#2 Run = 1'b1;
//   Continue = 1'b1;	
//
//#2 Run = 1'b0;
//
//#2 Run = 1'b1;
//
//while (1) begin
//	#2 $display("ADDR = %0d", ADDR);  
//	if (ADDR == 16'hFFFF) begin
//		SW = 16'h0006;
//		#10;
//		break;
//	end
//end
//
//while (1) begin
//	#2 $display("LED = %0d", LED);  
//	if (LED == 16'h0001) begin
//		SW = 16'h038A;
//		#2 Continue = 1'b0;
//		#2 Continue = 1'b1;
//		#6;
//		break;
//	end
//end
//
//while (1) begin
//	#2 $display("LED = %0d", LED);  
//	if (LED == 16'h0002) begin
//		SW = 16'h0149;
//		#2 Continue = 1'b0;
//		#2 Continue = 1'b1;
//		#6;
//		break;
//	end
//end
//
//while (1) begin
//	#2 $display("LED = %0d", LED);  
//	if (LED == 16'h0002) begin
//		SW = 16'h02F;
//		#2 Continue = 1'b0;
//		#2 Continue = 1'b1;
//		#6;
//		break;
//	end
//end

// Test 3: Self-Modifying Code Test
//integer prevLED = 0;
//
//#2 Run = 1'b0;
//   Continue = 1'b0;
//	
//#2 Run = 1'b1;
//	Continue = 1'b0;
//
//#2 Run = 1'b1;
//   Continue = 1'b1;	
//
//#2 Run = 1'b0;
//
//#2 Run = 1'b1;
//
//while (1) begin
//	#2 $display("ADDR = %0d", ADDR);  
//	if (ADDR == 16'hFFFF) begin
//		SW = 16'h000B;
//		#10;
//		break;
//	end
//end
//
//repeat(5) begin
//	while (1) begin
//		#2 $display("LED = %0d", LED);  
//		if (LED == prevLED + 1) begin
//			prevLED = prevLED + 1;
//			SW = 16'h03FF;
//			#2 Continue = 1'b0;
//			#2 Continue = 1'b1;
//			#6;
//			break;
//		end
//	end
//end

// Test 4: XOR Test
//#2 Run = 1'b0;
//   Continue = 1'b0;
//	
//#2 Run = 1'b1;
//	Continue = 1'b0;
//
//#2 Run = 1'b1;
//   Continue = 1'b1;	
//
//#2 Run = 1'b0;
//
//#2 Run = 1'b1;
//
//while (1) begin
//	#2 $display("ADDR = %0d", ADDR);  
//	if (ADDR == 16'hFFFF) begin
//		SW = 16'h0014;
//		#10;
//		break;
//	end
//end
//
//// Answer: 0x02dd
//while (1) begin
//		#2 $display("LED = %0d", LED);  
//		if (LED == 16'h0001) begin
//			SW = 16'h0073;
//			#2 Continue = 1'b0;
//			#2 Continue = 1'b1;
//			#6;
//			break;
//		end
//end
//
//while (1) begin
//		#2 $display("LED = %0d", LED);  
//		if (LED == 16'h0002) begin
//			SW = 16'h02ae;
//			#2 Continue = 1'b0;
//			#2 Continue = 1'b1;
//			#6;
//			break;
//		end
//end
//
//// Next
//while (1) begin
//		#2 $display("LED = %0d", LED);  
//		if (LED == 16'h0005) begin
//			#2 Continue = 1'b0;
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
//		#2 $display("HERE");
//		SW = 16'h0003;
//		#2 Continue = 1'b0;
//		#2 Continue = 1'b1;
//		#10;
//		break;
//	end
//end
//
//while (1) begin
//	if (LED == 16'h03FF) begin
//		#2 $display("Finished");
//		break;
//	end
//	#2 Continue = 1'b0;
//	#2 Continue = 1'b1;
//end
	
end

endmodule
