Max-Y-Ma/ECE-385/Lab2/Week2/logic_processor_4bit/Processor.sv

//4-bit logic processor top level module
//for use with ECE 385 Spring 2021
//last modified by Zuofu Cheng


//Always use input/output logic types when possible, prevents issues with tools that have strict type enforcement

module Processor (input logic   Clk,     // Internal
                                Reset,   // Push button 0
                                LoadA,   // Push button 1
                                LoadB,   // Push button 2
                                Execute, // Push button 3
                  input  logic [7:0]  Din,     // input data
				  //Hint for SignalTap, you want to comment out the following 2 lines to hardwire values for F and R
//                  input  logic [2:0]  F,       // Function select 
//                  input  logic [1:0]  R,       // Routing select
                  output logic [3:0]  LED,     // DEBUG
                  output logic [7:0]  Aval,    // DEBUG
                                Bval,    // DEBUG
                  output logic [6:0]  AhexL,
                                AhexU,
                                BhexL,
                                BhexU);

	 //local logic variables go here
	 logic Reset_SH, LoadA_SH, LoadB_SH, Execute_SH;
	 logic [2:0] F_S;
	 logic [1:0] R_S;
	 logic Ld_A, Ld_B, newA, newB, opA, opB, bitA, bitB, Shift_En,
	       F_A_B;
	 logic [7:0] A, B, Din_S;
	 
	 
	 //We can use the "assign" statement to do simple combinational logic
	 assign Aval = A;
	 assign Bval = B;
	 assign LED = {Execute_SH,LoadA_SH,LoadB_SH,Reset_SH}; //Concatenate is a common operation in HDL
	 
	 //Note that you can hardwire F and R here with 'assign'. What to assign them to? Check the demo points!
	 //Remember that when you comment out the ports above, you will need to define F and R as variables
	 //uncomment the following lines when you hardwire F and R (This was the solution to the problem during Q/A)
	 logic [2:0] F;
	 logic [1:0] R;
	 assign F = 3'b010;	// XOR
	 assign R = 2'b10;	// F, B
	 
	 //Instantiation of modules here
	 register_unit    reg_unit (
                        .Clk(Clk),
                        .Reset(Reset_SH),
                        .Ld_A, //note these are inferred assignments, because of the existence a logic variable of the same name
                        .Ld_B,
                        .Shift_En,
                        .D(Din_S),
                        .A_In(newA),
                        .B_In(newB),
                        .A_out(opA),
                        .B_out(opB),
                        .A(A),
                        .B(B) );
    compute          compute_unit (
								.F(F_S),
                        .A_In(opA),
                        .B_In(opB),
                        .A_Out(bitA),
                        .B_Out(bitB),
                        .F_A_B );
    router           router (
								.R(R_S),
                        .A_In(bitA),
                        .B_In(bitB),
                        .A_Out(newA),
                        .B_Out(newB),
                        .F_A_B );
	 control          control_unit (
                        .Clk(Clk),
                        .Reset(Reset_SH),
                        .LoadA(LoadA_SH),
                        .LoadB(LoadB_SH),
                        .Execute(Execute_SH),
                        .Shift_En,
                        .Ld_A,
                        .Ld_B );
	 HexDriver        HexAL (
                        .In0(A[3:0]),
                        .Out0(AhexL) );
	 HexDriver        HexBL (
                        .In0(B[3:0]),
                        .Out0(BhexL) );
								
	 //When you extend to 8-bits, you will need more HEX drivers to view upper nibble of registers, for now set to 0
	 HexDriver        HexAU (
                        .In0(A[7:4]),
                        .Out0(AhexU) );	
	 HexDriver        HexBU (
								.In0(B[7:4]),
                        .Out0(BhexU) );
								
	  //Input synchronizers required for asynchronous inputs (in this case, from the switches)
	  //These are array module instantiations
	  //Note: S stands for SYNCHRONIZED, H stands for active HIGH
	  //Note: We can invert the levels inside the port assignments
	  sync button_sync[3:0] (Clk, {~Reset, LoadA, LoadB, ~Execute}, {Reset_SH, LoadA_SH, LoadB_SH, Execute_SH});
	  sync Din_sync[7:0] (Clk, Din, Din_S);
	  sync F_sync[2:0] (Clk, F, F_S);
	  sync R_sync[1:0] (Clk, R, R_S);
	  
endmodule
