Max-Y-Ma/ECE-385/Lab5/slc_microprocessor/src/slc3.sv

//------------------------------------------------------------------------------
// Company: 		 UIUC ECE Dept.
// Engineer:		 Stephen Kempf
//
// Create Date:    
// Design Name:    ECE 385 Lab 5 Given Code - SLC-3 top-level (Physical RAM)
// Module Name:    SLC3
//
// Comments:
//    Revised 03-22-2007
//    Spring 2007 Distribution
//    Revised 07-26-2013
//    Spring 2015 Distribution
//    Revised 09-22-2015 
//    Revised 06-09-2020
//	  Revised 03-02-2021
//------------------------------------------------------------------------------


module slc3(
	input logic [9:0] SW,
	input logic	Clk, Reset, Run, Continue,
	output logic [9:0] LED,
	input logic [15:0] Data_from_SRAM,
	output logic OE, WE,
	output logic [6:0] HEX0, HEX1, HEX2, HEX3,
	output logic [15:0] ADDR,
	output logic [15:0] Data_to_SRAM
);

// Internal connections
logic LD_MAR, LD_MDR, LD_IR, LD_BEN, LD_CC, LD_REG, LD_PC, LD_LED;
logic GatePC, GateMDR, GateALU, GateMARMUX;
logic SR2MUX, ADDR1MUX;
logic BEN, MIO_EN, DRMUX, SR1MUX;
logic [1:0] PCMUX, ADDR2MUX, ALUK;
logic [15:0] MDR_In;
logic [15:0] MAR, MDR, IR;
logic [15:0] PC, BUS;

logic [3:0] hex_4 [3:0];
HexDriver hex_drivers[3:0] (hex_4, {HEX3, HEX2, HEX1, HEX0});

assign ADDR = MAR; 
assign MIO_EN = OE;

// Datapath
datapath d0 (.*);

// I/O controller
Mem2IO memory_subsystem(
    .*, .Reset(Reset), .ADDR(ADDR), .Switches(SW),
    .HEX0(hex_4[0][3:0]), .HEX1(hex_4[1][3:0]), .HEX2(hex_4[2][3:0]), .HEX3(hex_4[3][3:0]),
    .Data_from_CPU(MDR), .Data_to_CPU(MDR_In),
    .Data_from_SRAM(Data_from_SRAM), .Data_to_SRAM(Data_to_SRAM)
);

// State Machine ***ADD BEN*** - done
ISDU state_controller(
	.*, .Reset(Reset), .Run(Run), .Continue(Continue),
	.Opcode(IR[15:12]), .IR_5(IR[5]), .IR_11(IR[11]), .ledVect12(IR[9:0]),
   .Mem_OE(OE), .Mem_WE(WE)
);

// SRAM WE register
//logic SRAM_WE_In, SRAM_WE;
//// SRAM WE synchronizer
//always_ff @(posedge Clk or posedge Reset_ah)
//begin
//	if (Reset_ah) SRAM_WE <= 1'b1; //resets to 1
//	else 
//		SRAM_WE <= SRAM_WE_In;
//end

	
endmodule
