Max-Y-Ma/ECE-385/Lab5/slc_microprocessor/src/ALU.sv

module ALU(
	input logic [15:0] A, B,
	input logic [1:0] ALUK,
	output logic [15:0] ALU_OUT
);

	// Compute Output
	always_comb
	begin
		unique case (ALUK)
			2'b00 : ALU_OUT = A + B;
			2'b01 : ALU_OUT = A & B;
			2'b10 : ALU_OUT = ~A;
			2'b11 : ALU_OUT = A;
		endcase
	end

endmodule
