Max-Y-Ma/ECE-385/Lab4/8-bit-multiplier/src/reg_8.sv

module reg_8(
	input  logic Clk, Reset, Shift_In, Load, Shift_En,
	input  logic [7:0]  Data_In,
	output logic Shift_Out,
	output logic [7:0]  Data_Out
	);

	// 8-bit Shift Register Module
	always_ff @ (posedge Clk) 
	begin
		if (Reset) 
		begin
			Data_Out <= 8'b00000000;
		end 
		else if (Load) 
		begin
			Data_Out <= Data_In;
		end 
		else if (Shift_En) 
		begin
			Data_Out = {Shift_In, Data_Out[7:1]};
		end
	end
	
	assign Shift_Out = Data_Out[0];

endmodule
