Max-Y-Ma/ECE-385/(commit log)

2023-01-23 Organized files and added Fritzing schematic
    [4-bit_ALU.fzz]
2023-01-24 Adding Fritzing
    [4-bit_ALU.fzz]
2023-01-24 Added most of the remaining chips and began routing
    [4-bit_ALU.fzz]
2023-01-25 Completed labeling and debugging section in fritzing.
    [4-bit_ALU.fzz]
2023-01-27 Added Files for Week 2
    [4-bit_ALU.fzz]
2023-02-02 Completed Lab 2.2, Ready for demo
    [Logic_Processor_8bit.smp_dump.txt, demo_signal_tap.stp, demo_signal_tap_auto_stripped.stp]
2023-02-04 Added Lab 3 Material
    [demo_signal_tap.stp, demo_signal_tap_auto_stripped.stp]
2023-02-07 Added Lab 3 Pin Assignments
    [Full_Pin_Assignment.csv]
2023-02-07 Added Test Bench, Completed 16-bit CLA, Passes Test Cases, No On-board Testing
2023-02-08 Testbench runs, wrong output
    [adder_toplevel.sv, ripple_adder.sv]
2023-02-11 Add Lab 4 Materials
    [Full_Pin_Assignment.csv]
2023-02-13 Lab 2 Report files
    [4-bit_ALU.fzz]
2023-02-16 Fixed Loading and Reseting of Registers
    [control_unit.sv, multiplier_toplevel.sv, testbench.sv]
2023-02-16 Test Case Working on FPGA
2023-02-18 Added Lab 5 Material
2023-02-18 First Synthesis and Pin Assignments
2023-02-24 Fixed Run/Continue Bug by Adding Wait Cycles for Memory. Demo Week 1 Ready.
    [stp3.stp]
2023-02-24 Refactored Code. Ready to begin Lab 5.2
    [stp3.stp]
2023-03-02 Tests run partially - some display issues
    [memory_contents.sv, slc3.sv, testbench.sv]
2023-03-08 Added Lab6.1 QA file. NIOS SoC properly executes LED0 blink program.
2023-03-14 Completed Lab Report #5
    [Multiply_Test.stp, stp3.stp]
